solderparty/rp2040_stamp_hw/schematics.pdf

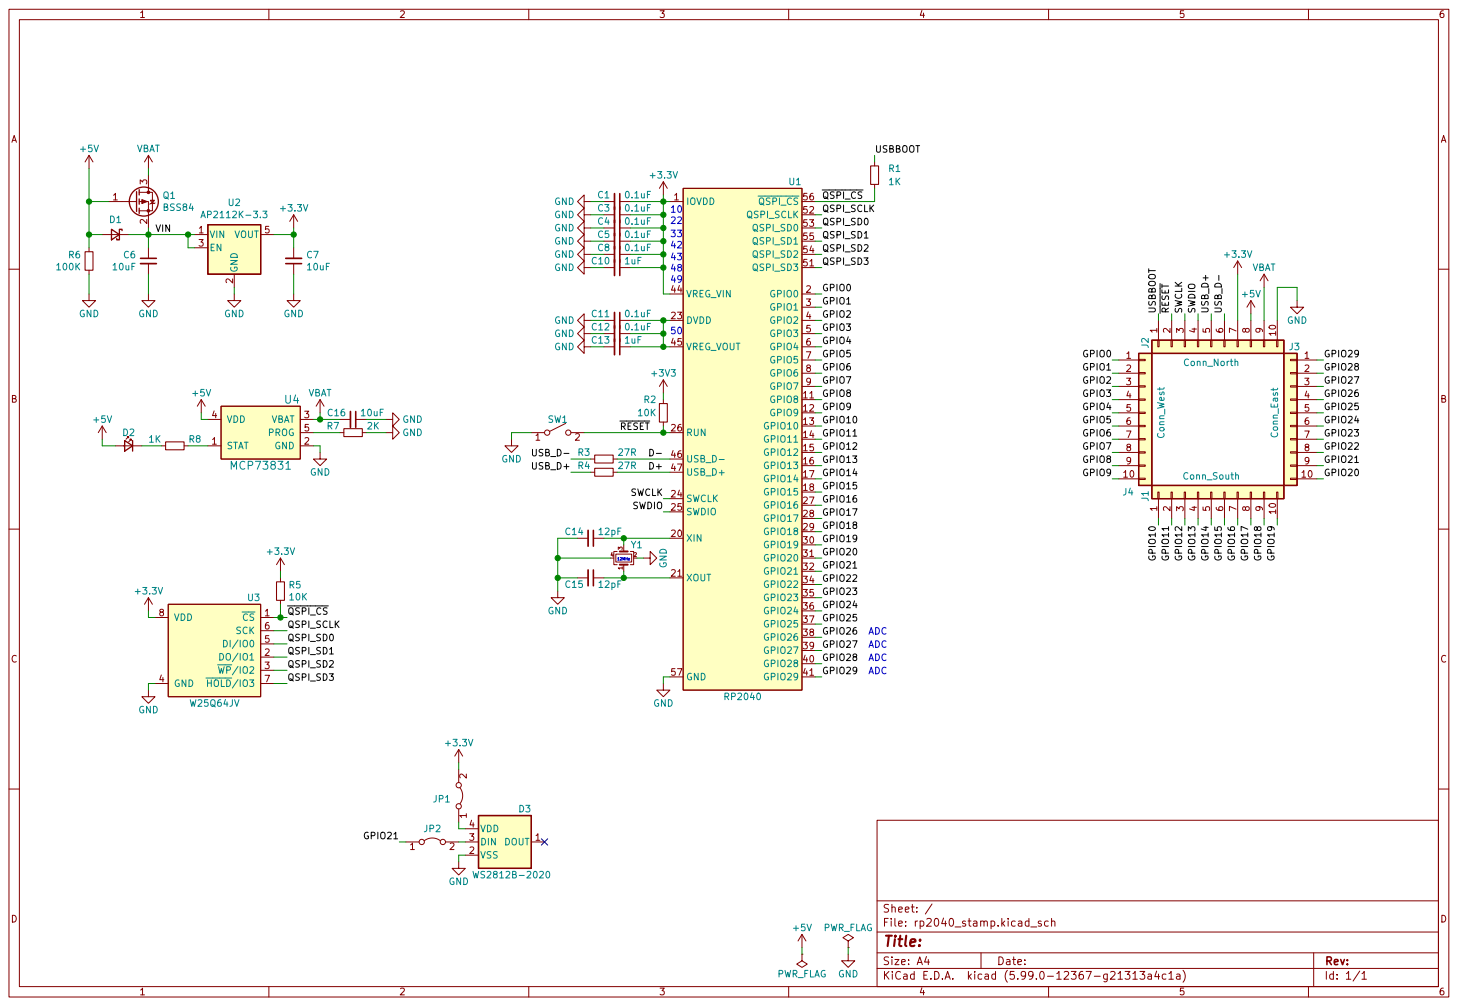
[picture p2: page 1]

2 3 Q1BSS84 STAT 1 GND 2 VBAT 3 VDD 4 PROG 5 U4 MCP73831 GND GND
