solderparty/rp2040_stamp_hw/rp2040_stamp.kicad_sch

## KiCad design rp2040_stamp.kicad_sch (2021-12-02)

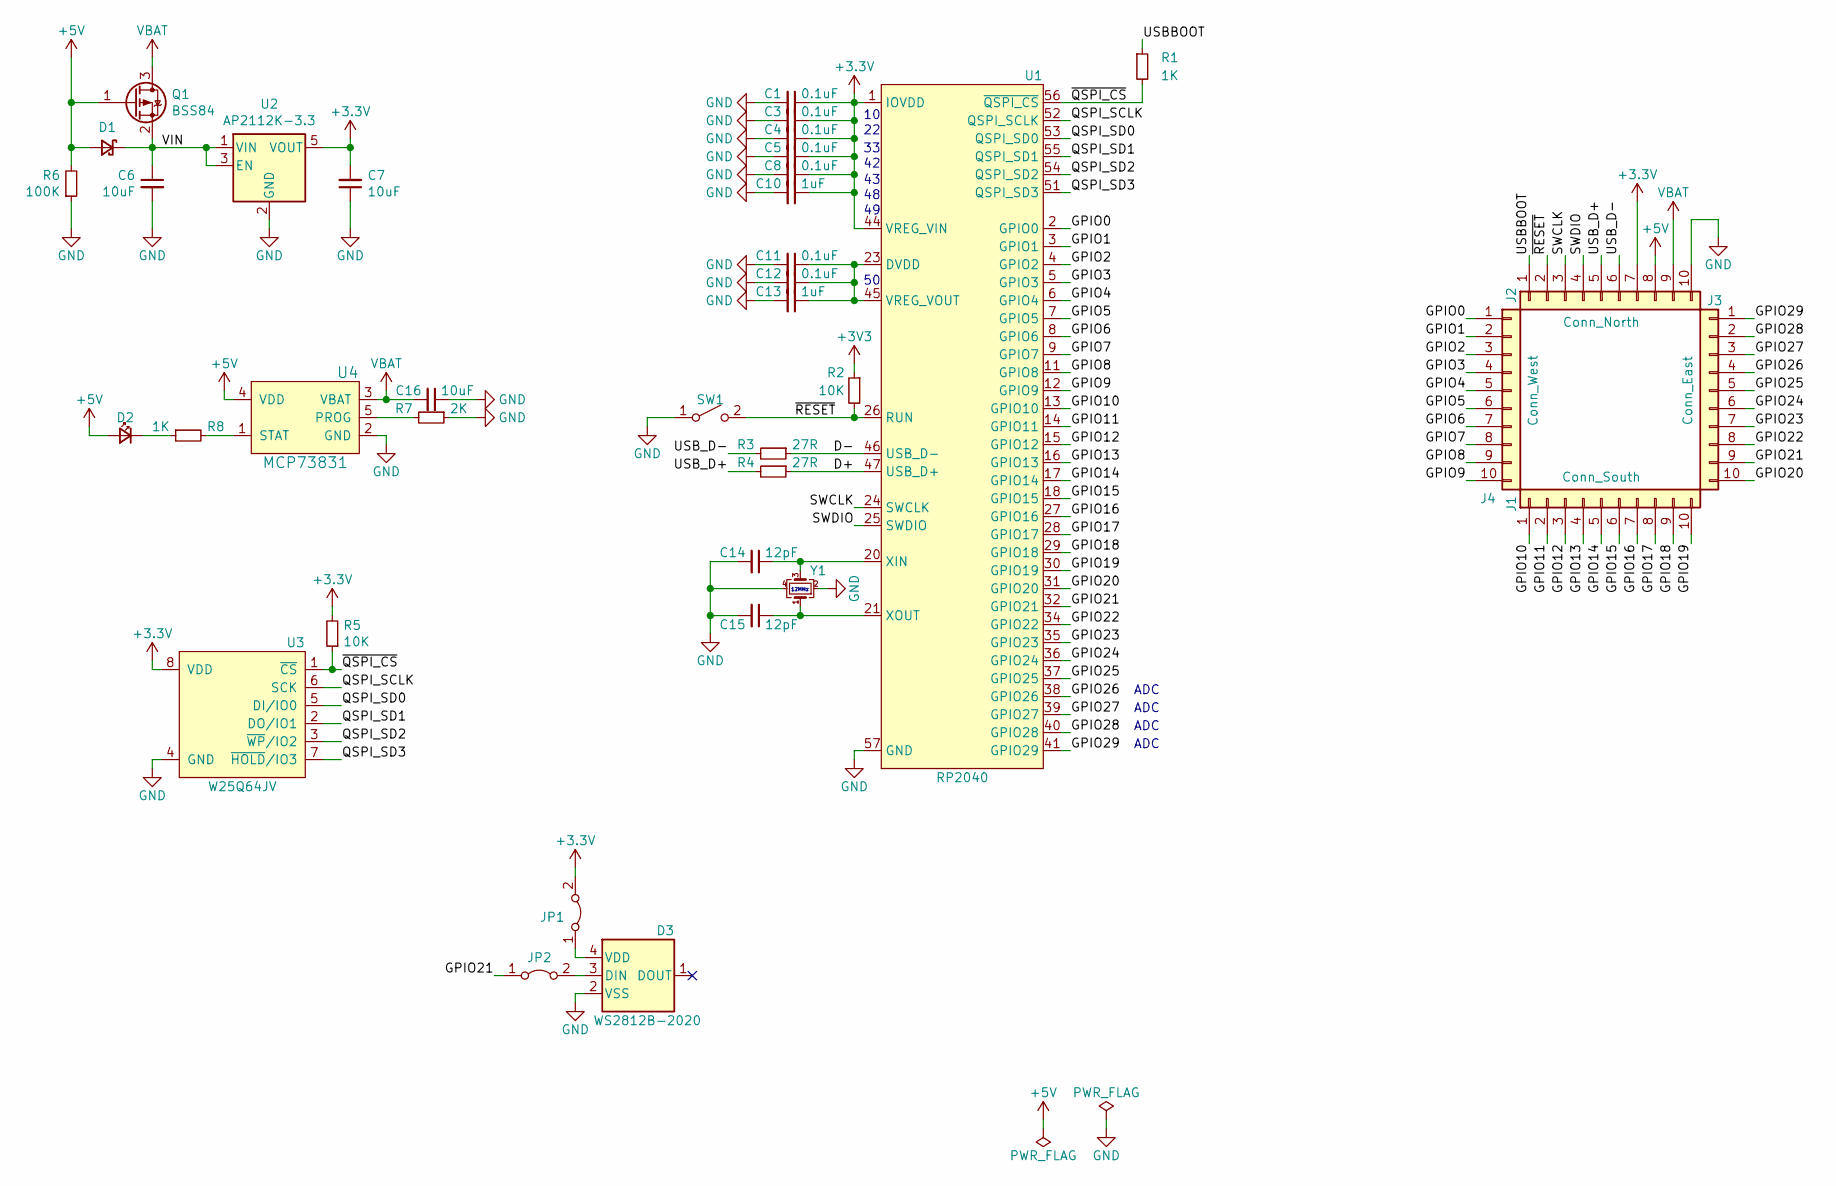
[picture p3: schematic rp2040_stamp.kicad_sch]

Parts:
C1, C3, C4, C5, C8, C11, C12: 0.1uF; C_0603_1608Metric
C6, C7, C16: 10uF; C_0603_1608Metric
C10, C13: 1uF; C_0603_1608Metric
C14, C15: 12pF; C_0603_1608Metric
D1: D_Schottky_Small; D_SOD-323; LCSC C114023
D2: LED_CHR; LED_0603_1608Metric
D3: WS2812B-2020; LCSC C965555
J1: Conn_South; Castellated_1x10_P2.00mm_Vertical
J2: Conn_North; Castellated_1x10_P2.00mm_Vertical
J3: Conn_East; Castellated_1x10_P2.00mm_Vertical
J4: Conn_West; Castellated_1x10_P2.00mm_Vertical
JP1: Jumper_Neopixel_VDD; SolderJumper-2_P1.3mm_Bridged_RoundedPad1.0x1.5mm
JP2: Jumper_Neopixel; SolderJumper-2_P1.3mm_Bridged_RoundedPad1.0x1.5mm
Q1: BSS84; SOT-23; LCSC C85202
R1, R8: 1K; R_0603_1608Metric
R2, R5: 10K; R_0603_1608Metric
R3, R4: 27R; R_0603_1608Metric
R6: 100K; R_0603_1608Metric
R7: 2K; R_0603_1608Metric
SW1: SW_RESET; SW_SPST_B3U-1000P
U1: RP2040; QFN-56_EP_7x7_Pitch0.4mm
U2: AP2112K-3.3; SOT-23-5; LCSC C51118
U3: W25Q64JV; WSON-8-1EP_6x5mm_P1.27mm_EP3.4x4mm
U4: MCP73831; SOT-23-5; LCSC C14879
Y1: XYDBPCNANF-12MHZ; Crystal_SMD_2520-4Pin_2.5x2.0mm; LCSC C521567

Connections:
+3.3V: C1.1, C3.1, C4.1, C5.1, C7.2, C8.1, C10.1, J2.7, JP1.2 (B), R5.2, U1.1 (IOVDD), U1.10 (IOVDD), U1.22 (IOVDD), U1.33 (IOVDD), U1.42 (IOVDD), U1.43 (ADC_AVDD), U1.44 (VREG_VIN), U1.48 (USB_VDD), U1.49 (IOVDD), U2.5 (VOUT), U3.8 (VDD)
+3V3: R2.1
+5V: D1.2 (A), D2.2 (A), J2.8, Q1.1 (G), R6.2, U4.4 (VDD)
D+: R4.1, U1.47 (USB_D+)
D-: R3.1, U1.46 (USB_D-)
GND: C1.2, C3.2, C4.2, C5.2, C6.2, C7.1, C8.2, C10.2, C11.2, C12.2, C13.2, C14.2, C15.2, C16.1, D3.2 (VSS), J2.10, R6.1, R7.1, SW1.1 (A), U1.19 (TESTEN), U1.57 (GND), U2.2 (GND), U3.4 (GND), U3.9 (GND), U4.2 (GND), Y1.2, Y1.4
GPIO0: J4.1, U1.2 (GPIO0)
GPIO1: J4.2, U1.3 (GPIO1)
GPIO2: J4.3, U1.4 (GPIO2)
GPIO3: J4.4, U1.5 (GPIO3)
GPIO4: J4.5, U1.6 (GPIO4)
GPIO5: J4.6, U1.7 (GPIO5)
GPIO6: J4.7, U1.8 (GPIO6)
GPIO7: J4.8, U1.9 (GPIO7)
GPIO8: J4.9, U1.11 (GPIO8)
GPIO9: J4.10, U1.12 (GPIO9)
GPIO10: J1.1, U1.13 (GPIO10)
GPIO11: J1.2, U1.14 (GPIO11)
GPIO12: J1.3, U1.15 (GPIO12)
GPIO13: J1.4, U1.16 (GPIO13)
GPIO14: J1.5, U1.17 (GPIO14)
GPIO15: J1.6, U1.18 (GPIO15)
GPIO16: J1.7, U1.27 (GPIO16)
GPIO17: J1.8, U1.28 (GPIO17)
GPIO18: J1.9, U1.29 (GPIO18)
GPIO19: J1.10, U1.30 (GPIO19)
GPIO20: J3.10, U1.31 (GPIO20)
GPIO21: J3.9, JP2.1 (A), U1.32 (GPIO21)
GPIO22: J3.8, U1.34 (GPIO22)
GPIO23: J3.7, U1.35 (GPIO23)
GPIO24: J3.6, U1.36 (GPIO24)
GPIO25: J3.5, U1.37 (GPIO25)
GPIO26: J3.4, U1.38 (GPIO26)
GPIO27: J3.3, U1.39 (GPIO27)
GPIO28: J3.2, U1.40 (GPIO28)
GPIO29: J3.1, U1.41 (GPIO29)
unnamed: C11.1, C12.1, C13.1, U1.23 (DVDD), U1.45 (VREG_VOUT), U1.50 (DVDD)
unnamed: C14.1, U1.20 (XIN), Y1.3
unnamed: C15.1, U1.21 (XOUT), Y1.1
unnamed: D2.1 (K), R8.1
unnamed: D3.3 (DIN), JP2.2 (B)
unnamed: D3.4 (VDD), JP1.1 (A)
unnamed: R7.2, U4.5 (PROG)
unnamed: R8.2, U4.1 (STAT)
QSPI_SCLK: U1.52 (QSPI_SCLK), U3.6 (SCK)
QSPI_SD0: U1.53 (QSPI_SD0), U3.5 (DI/IO0)
QSPI_SD1: U1.55 (QSPI_SD1), U3.2 (DO/IO1)
QSPI_SD2: U1.54 (QSPI_SD2), U3.3 (~WP~/IO2)
QSPI_SD3: U1.51 (QSPI_SD3), U3.7 (~HOLD~/IO3)
SWCLK: J2.3, U1.24 (SWCLK)
SWDIO: J2.4, U1.25 (SWDIO)
USBBOOT: J2.1, R1.1
USB_D+: J2.5, R4.2
USB_D-: J2.6, R3.2
VBAT: C16.2, J2.9, Q1.3 (D), U4.3 (VBAT)
VIN: C6.1, D1.1 (K), Q1.2 (S), U2.1 (VIN), U2.3 (EN)
~QSPI_CS~: R1.2, R5.1, U1.56 (~QSPI_CS~), U3.1 (~CS~)
~RESET~: J2.2, R2.2, SW1.2 (B), U1.26 (RUN)

Notes on the sheet:
12MHz
ADC
