solderparty/rp2040_stamp_hw/(threads)

Thread 2 (2022-01-12):

documentation request: requirements for battery

sknebel, 2022-01-12:
(I hope this is the correct place to ask)

After looking through the documentation, I'm left with two points around the battery circuitry that I'd like to see addressed in the documentation:

a) what charge current is used by the circuitry?

b) Are there requirements regarding additional protection circuits? I.e. there doesn't seem to be explicit protection against the battery voltage running low, unless the LDO reliably shuts off at a safe point. If cells with built-in protection circuits are recommended this should be mentioned. (It's pretty much the default with pouch cells, but some users might try e.g. 18500 cells which are available both with and without protection circuits)

arturo182, 2022-01-13:
Hi, yes this is a good place to ask.

The PROG resistor used is 2KOhm, using the formula from the MCP73831 datasheet: `1000V/2000Ohm = 500mA`.

No, there is no built-in protection for the battery, the design was made with the assumption that pretty much all modern legit batteries have one, but I will make make a note just so others are aware.

Closed 2024-09-06.

Thread 4 (2023-07-04):

Missing Components...

naujoks-stefan, 2023-07-04:
hello,
first of all a huge praise!!! I'm working on the rp2040 right now and it's awesome!!! I downloaded the project for Kicad. I want to build it via JLCPCB. I have two challenges. The GigaDevice 25Q64CWIG chip is no longer available. What is an alternative? JLCPCB does not support smd solder jumper. Is smd 0603 0k resistor an alternative?

best Stefan

arturo182, 2023-07-04:
The solder jumpers are not components to be placed, they're just a bit of copper on the PCB. As for the FLASH chip, any 3.3V FLASH with the same footprint (6x5mm WSON8) and pinout should work.

naujoks-stefan, 2023-07-05:
the answer helped me a lot. But it's not that easy to find an equivalent part without revising the entire layout ;-)) I have an additional question: WS2812B-2020 is more of a feature, isn't it? could this component be removed without affecting it? Background: JLCPCB supports this only in the standard. Here are the edge specifications min 70mmx70mm. that would be total nonsense ;-)) hence my idea to simply remove them.

arturo182, 2023-07-07:
Hmm, if you find a flash with same footprint and pinout you shouldn't have to touch the layout at all. As for the LED, yes, it's just a nice-to-have, you can skip it and the Stamp is still functional.

certram, 2024-08-15:
@naujoks-stefan Have you built the rp2040 stamp successfully?

Closed 2024-09-06.

Thread 5 (2024-08-19):

Missing Silkscreen Fiducial Marker

certram, 2024-08-19:
Hello, I am new to this PCB project. I send the Bom file to PCB Manufacturer and the CSR gave the feedback to me. He tells me that I need to provide the Silkscreen Fiducial Marker. How can I generate this file from KiCad software?

arturo182, 2024-08-19:
I'm not sure what they mean by that, the silkscreen gerber files should be enough.

certram, 2024-08-20:
It's the coordinate of every components. Like the picture shown as follows:

certram, 2024-08-20:
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

arturo182, 2024-08-20:
I am still unsure, I didn't need that for mass production.

certram, 2024-08-20:
I use the www.jiepei.com to order. What's your website? https://www.jlc.com or other?

arturo182, 2024-08-20:
I use JLCPCB for prototypes and Makerfabs for production.

certram, 2024-08-23:
Thanks for replying.

Closed 2024-09-06.
